FREILab/RFID-Box-3D/hw/PCB/3D-models/3403.0159.24.STEP

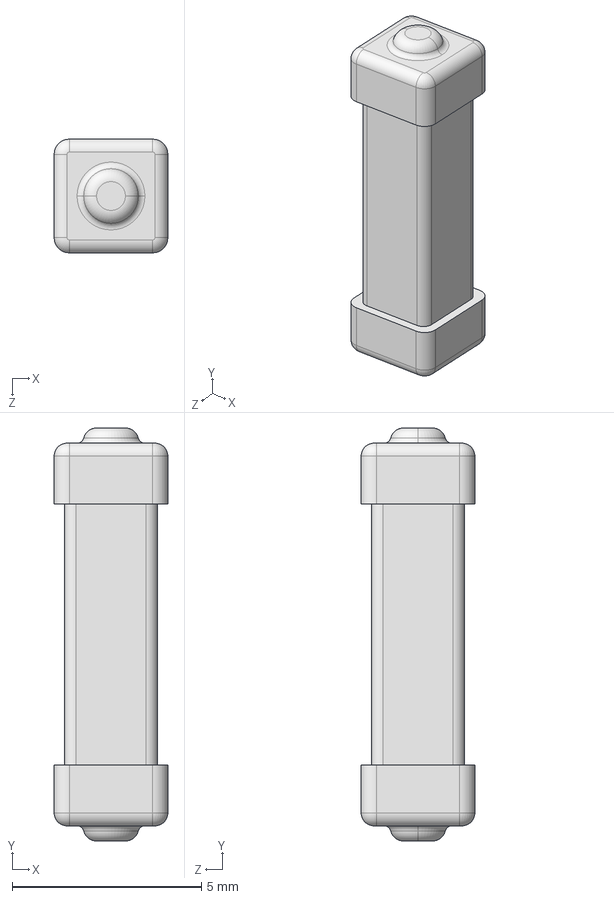
[picture p2: CAD file, 2025-03-09]
hw/PCB/3D-models/3403.0159.24.STEP
3.00 x 10.9 x 3.00 mm
