FREILab/RFID-Box-3D/hw/PCB/3D-models/TBA_2-2411.step

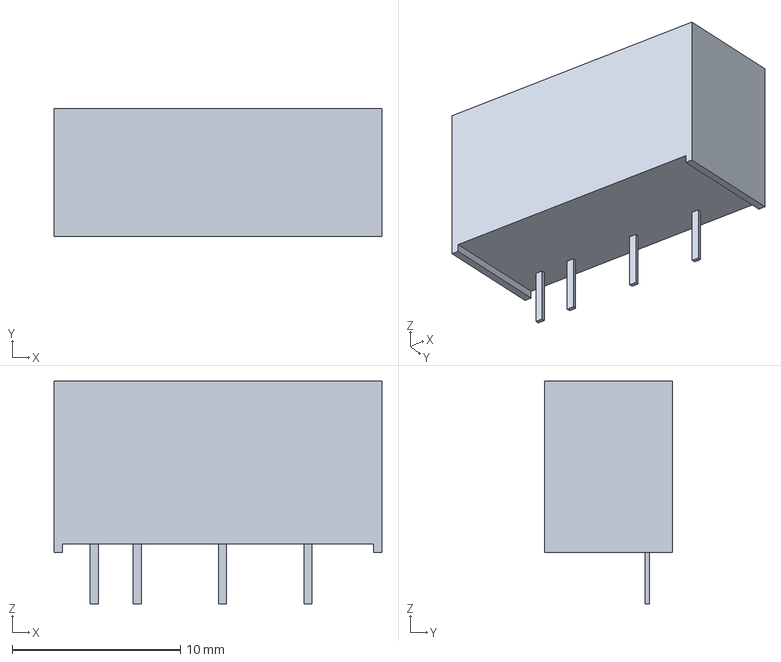
[picture p3: CAD file, 2025-03-09]
hw/PCB/3D-models/TBA_2-2411.step
19.5 x 7.60 x 13.2 mm
