FREILab/RFID-Box-3D/hw/PCB/3D-models/Female2.54MM1x15.step

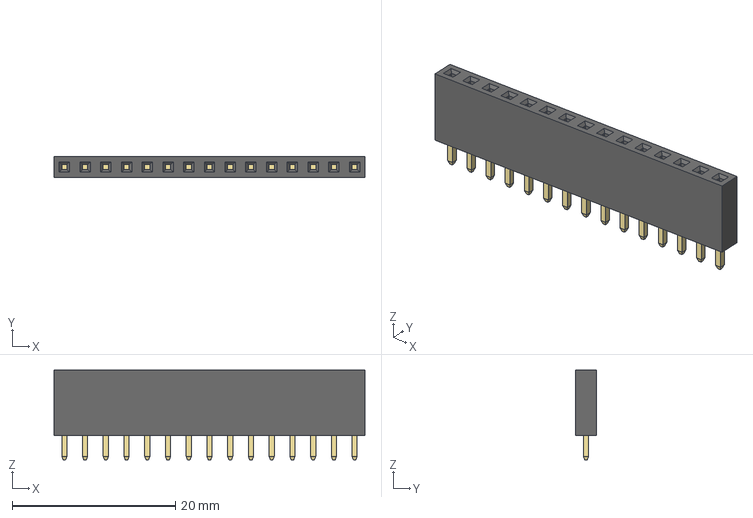
[picture p4: CAD file, 2025-03-09]
hw/PCB/3D-models/Female2.54MM1x15.step
38.1 x 2.54 x 11.0 mm
