FREILab/RFID-Box-3D/hw/PCB/3D-models/0680L0375-01.step

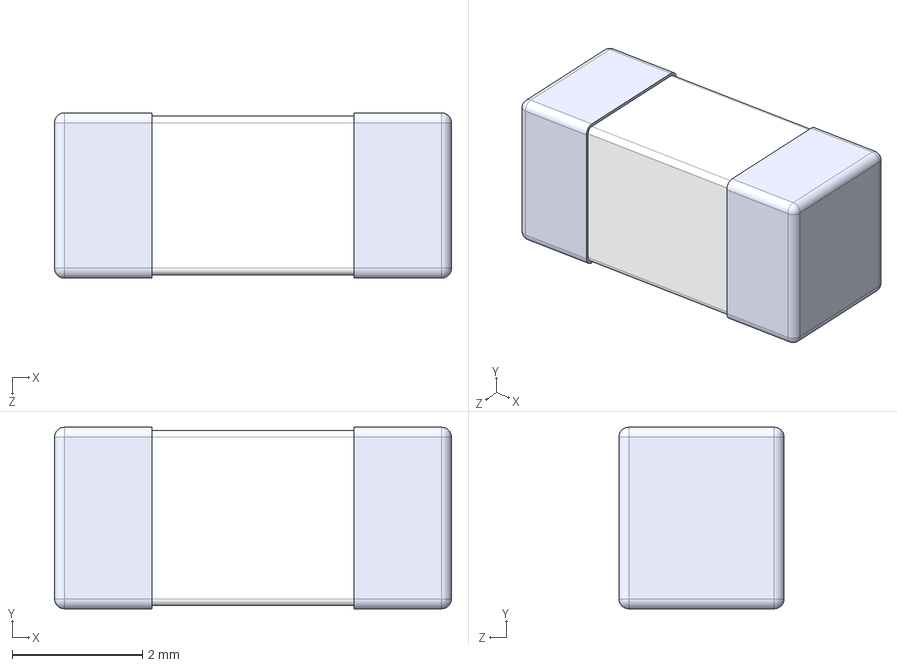
[picture p5: CAD file, 2025-03-09]
hw/PCB/3D-models/0680L0375-01.step
6.10 x 2.79 x 2.54 mm
