FREILab/RFID-Box-3D/hw/PCB/RFID_Platine.kicad_pcb

## KiCad design hw/PCB/RFID_Platine.kicad_pcb (2025-05-25)

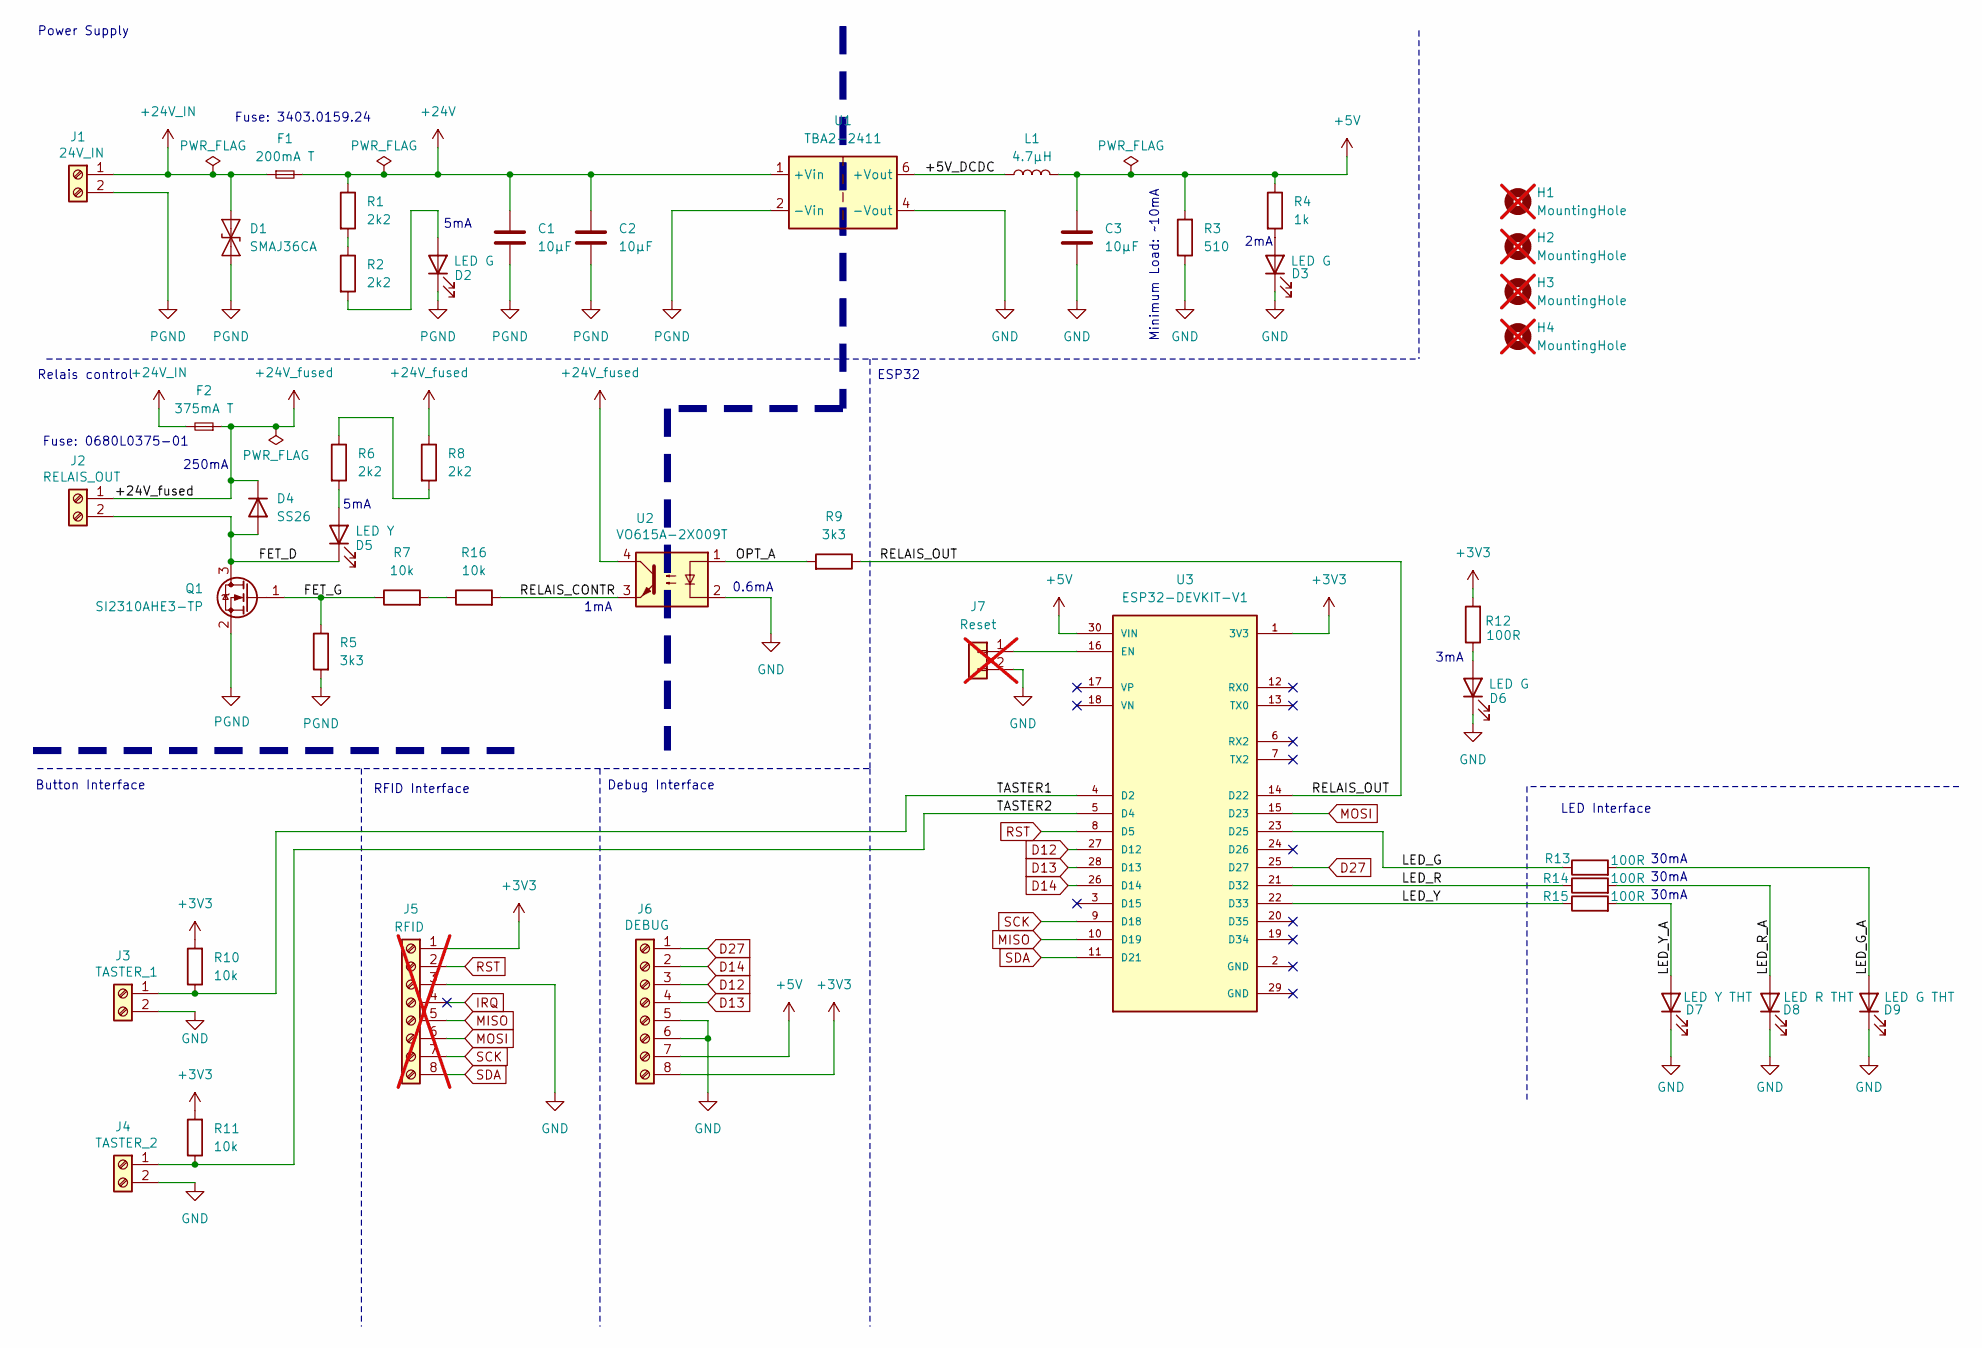
[picture p6: schematic RFID_Platine.kicad_sch, RFID Interface Board]

Parts:
C1, C2, C3: 10µF; C_0805_2012Metric; Voltage Rating 50V; Digikey 490-GRM21BR61H106KE43KCT-ND
D1: SMAJ36CA; D_SMA; Digikey SMAJ36CA-TPMSCT-ND
D2, D3, D6: LED G; LED_0603_1608Metric; Digikey 160-1183-1-ND
D4: SS26; D_SMA; Digikey SS26-LTPMSCT-ND
D5: LED Y; LED_0603_1608Metric; Digikey 160-1448-1-ND
D7: LED Y THT; LED_D5.0mm_Horizontal_O6.35mm_Z15.0mm; Digikey 1516-1362-ND
D8: LED R THT; LED_D5.0mm_Horizontal_O6.35mm_Z15.0mm; Digikey 1516-1359-ND
D9: LED G THT; LED_D5.0mm_Horizontal_O6.35mm_Z15.0mm; Digikey 1516-1364-ND
F1: 200mA T; Fuse_Schurter_UMZ250; Digikey 486-4658-1-ND
F2: 375mA T; Fuse_Littelfuse-NANO2-451_453; Digikey 5923-0680L0375-01CT-ND
H1, H2, H3, H4: MountingHole; MountingHole_4mm; not fitted
J1: 24V_IN; TerminalBlock_Phoenix_PT-1,5-2-3.5-H_1x02_P3.50mm_Horizontal; Digikey 277-1721-ND
J2: RELAIS_OUT; TerminalBlock_Phoenix_PT-1,5-2-3.5-H_1x02_P3.50mm_Horizontal; Digikey 277-1721-ND
J3: TASTER_1; TerminalBlock_Phoenix_PT-1,5-2-3.5-H_1x02_P3.50mm_Horizontal; Digikey 277-1721-ND
J4: TASTER_2; TerminalBlock_Phoenix_PT-1,5-2-3.5-H_1x02_P3.50mm_Horizontal; Digikey 277-1721-ND
J5: RFID; PinHeader_1x08_P2.54mm_Vertical; not fitted
J6: DEBUG; PinHeader_1x08_P2.54mm_Vertical
J7: Reset; PinHeader_1x02_P2.54mm_Vertical; not fitted
L1: 4.7µH; L_Chilisin_BMRB00060650; Digikey 445-174746-1-ND
Q1: SI2310AHE3-TP; SOT-23; Digikey 353-SI2310AHE3-TP-ND
R1, R2, R6, R8: 2k2; R_0603_1608Metric; Power Rating 100mW; Digikey 13-RC0603FR-132K2LCT-ND
R3: 510; R_0603_1608Metric; Power Rating 100mW; Digikey 311-510HRCT-ND
R4: 1k; R_0603_1608Metric; Power Rating 100mW; Digikey 311-1.00KHRCT-ND
R5, R9: 3k3; R_0603_1608Metric; Power Rating 100mW; Digikey 311-3.30KHRCT-ND
R7, R10, R11, R16: 10k; R_0603_1608Metric; Power Rating 100mW; Digikey 311-10.0KHRCT-ND
R12, R13, R14, R15: 100R; R_0805_2012Metric; Power Rating 125mW; Digikey 311-100CRCT-ND
U1: TBA2-2411; Converter_DCDC_TRACO_TBA2-xxxx_Single_THT; Digikey 1951-3441-ND
U2: VO615A-2X009T; DIP-4_W8.89mm_SMDSocket_LongPads; Digikey VO615A-2X009TCT-ND
U3: ESP32-DEVKIT-V1; MODULE_ESP32_DEVKIT_V1; PARTREV N/A

Connections:
+3V3: J5.1, J6.8, R10.2, R11.2, R12.2, U3.1 (3V3)
+5V: C3.1, J6.7, L1.2, R3.2, R4.1, U3.30 (VIN)
+24V: C1.1, C2.1, F1.2, R1.1, U1.1 (+Vin)
+24V_IN: D1.2 (A2), F1.1, F2.2, J1.1
+24V_fused: D4.1 (K), F2.1, J2.1, R8.1, U2.4
/+5V_DCDC: L1.1, U1.6 (+Vout)
/FET_D: D4.2 (A), D5.1 (K), J2.2, Q1.3 (D)
/FET_G: Q1.1 (G), R5.1, R7.1
/LED_G: R13.1, U3.23 (D25)
/LED_G_A: D9.2 (A), R13.2
/LED_R: R14.1, U3.21 (D32)
/LED_R_A: D8.2 (A), R14.2
/LED_Y: R15.1, U3.22 (D33)
/LED_Y_A: D7.2 (A), R15.2
/OPT_A: R9.2, U2.1
/RELAIS_CONTR: R16.2, U2.3
/RELAIS_OUT: R9.1, U3.14 (D22)
/TASTER1: J3.1, R10.1, U3.4 (D2)
/TASTER2: J4.1, R11.1, U3.5 (D4)
D12: J6.3, U3.27 (D12)
D13: J6.4, U3.28 (D13)
D14: J6.2, U3.26 (D14)
D27: J6.1, U3.25 (D27)
GND: C3.2, D3.1 (K), D6.1 (K), D7.1 (K), D8.1 (K), D9.1 (K), J3.2, J4.2, J5.3, J6.5, J6.6, J7.2, R3.1, U1.4 (-Vout), U2.2
IRQ: J5.4
MISO: J5.5, U3.10 (D19)
MOSI: J5.6, U3.15 (D23)
unnamed: D2.2 (A), R2.2
unnamed: D3.2 (A), R4.2
unnamed: D5.2 (A), R6.2
unnamed: D6.2 (A), R12.1
unnamed: J7.1, U3.16 (EN)
unnamed: R1.2, R2.1
unnamed: R6.1, R8.2
unnamed: R7.2, R16.1
PGND: C1.2, C2.2, D1.1 (A1), D2.1 (K), J1.2, Q1.2 (S), R5.2, U1.2 (-Vin)
RST: J5.2, U3.8 (D5)
SCK: J5.7, U3.9 (D18)
SDA: J5.8, U3.11 (D21)

Notes on the sheet:
2mA
30mA
Fuse: 3403.0159.24
RFID Interface
LED Interface
5mA
0.6mA
Relais control
1mA
3mA
Debug Interface
Button Interface
250mA
ESP32
Power Supply
Fuse: 0680L0375-01
Minimum Load: ~10mA

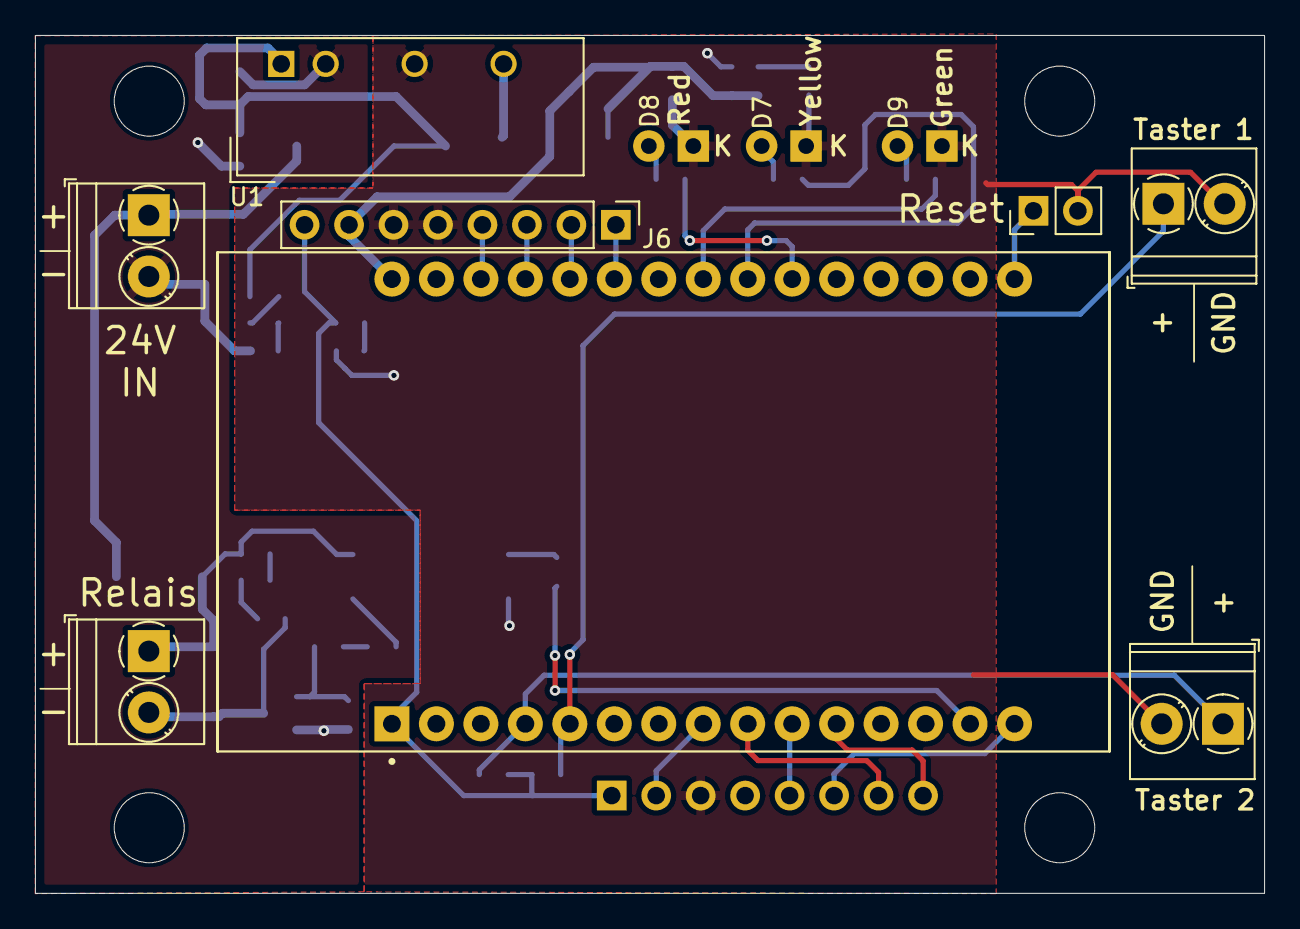
[picture p7: board RFID_Platine.kicad_pcb from above]

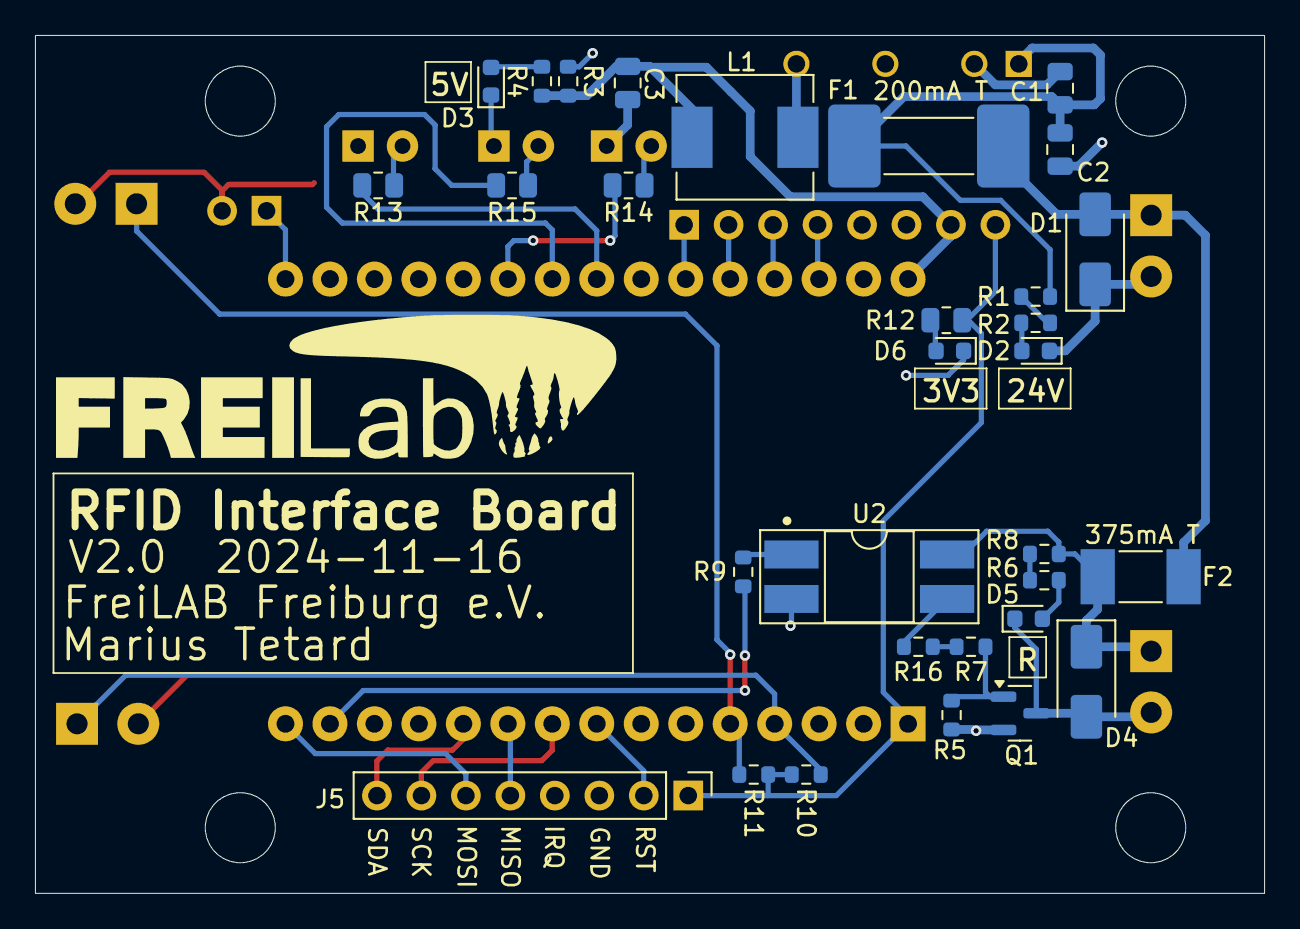
[picture p8: board RFID_Platine.kicad_pcb from below]

Board: 2 copper layers, 70.2 x 49.0 mm, 46 parts (31 on the bottom side), 38 nets.
