FREILab/RFID-Box-3D/(threads)

Thread 1 (2025-03-01):

Bekannte HW Bugs

mariuste, 2025-03-01:
- [ ] Connect GND of ESP
- [ ] R1, R2, R4 -> 10k
- [ ] R9 -> 1k
- [ ] R12 -> 3k3
- [ ] J5-> silkscreen für pin 1 fehlt (3V3)
- [ ] J1, J2, J3, J4 -> mit besseren Klemmen ersetzen (Cage), z.B. https://www.digikey.de/short/dq5mhdnq

Thread 2 (2025-03-01):

Taster 1 buggy

mariuste, 2025-03-01:
Taster ist nicht solide high oder low, ggf. library conflict

- [ ] untersuchen

mariuste, 2025-03-02:
die interne led des ESP32 war schuld. R10->220R

Closed 2025-03-02.
