FREILab/RFID-Box-3D/sw/RFID_3D_ESP32/config_3D.h

#ifndef CONFIG_3D_H
#define CONFIG_3D_H

#define WIFI_SSID "SSID"
#define WIFI_PASSWORD "password"
#define SERVER_IP "192.168.178.99"
#define AUTHENTICATION_TOKEN "token"
#define RFIDCARD_AUTH_CONST false

#define MACHINE_NAME "name" //defines the machine group for chekcing the permission
#define MACHINE_ID  "id" //used for the logfile in the backend 

#endif /* CONFIG_3D_H */
