FREILab/RFID-Box-3D/(commit log)

2024-01-20 Add sample config file.
2024-01-20 Fix bug where RFID-Board stops responding.
2025-03-01 add new hardware
    [0680L0375-01.step, 3403.0159.24.STEP, Female2.54MM1x15.step, RFID_Platine.kicad_pcb, RFID_Platine.kicad_sch, TBA_2-2411.step, bom.csv, designators.csv]
2025-03-02 move in folders
    [0680L0375-01.step, 3403.0159.24.STEP, Female2.54MM1x15.step, RFID_Platine.kicad_pcb, RFID_Platine.kicad_sch, TBA_2-2411.step, bom.csv, designators.csv]
2025-03-02 tried adding wifi and rfid; however stop button stopped wirking
2025-03-03 led now working
2025-03-04 mutex button flags
2025-03-09 add button debouncing
2025-03-09 fix formatting and failed card read
    [RFID_3D_ESP32.ino]
2025-03-09 fix last instability;enable output; final comit
    [RFID_3D_ESP32.ino]
2025-03-28 go back to normally open reset button
2025-03-28 add glitch filter for both buttons
    [RFID_3D_ESP32.ino]
2025-04-03 remove interrupt, fix timing
    [RFID_3D_ESP32.ino]
2025-05-25 add latest changes
    [RFID_Platine.kicad_pcb, RFID_Platine.kicad_sch]
